Romukeisari/inverter-hardware/mainboard-mini-kicad/mainboard-mini.pdf

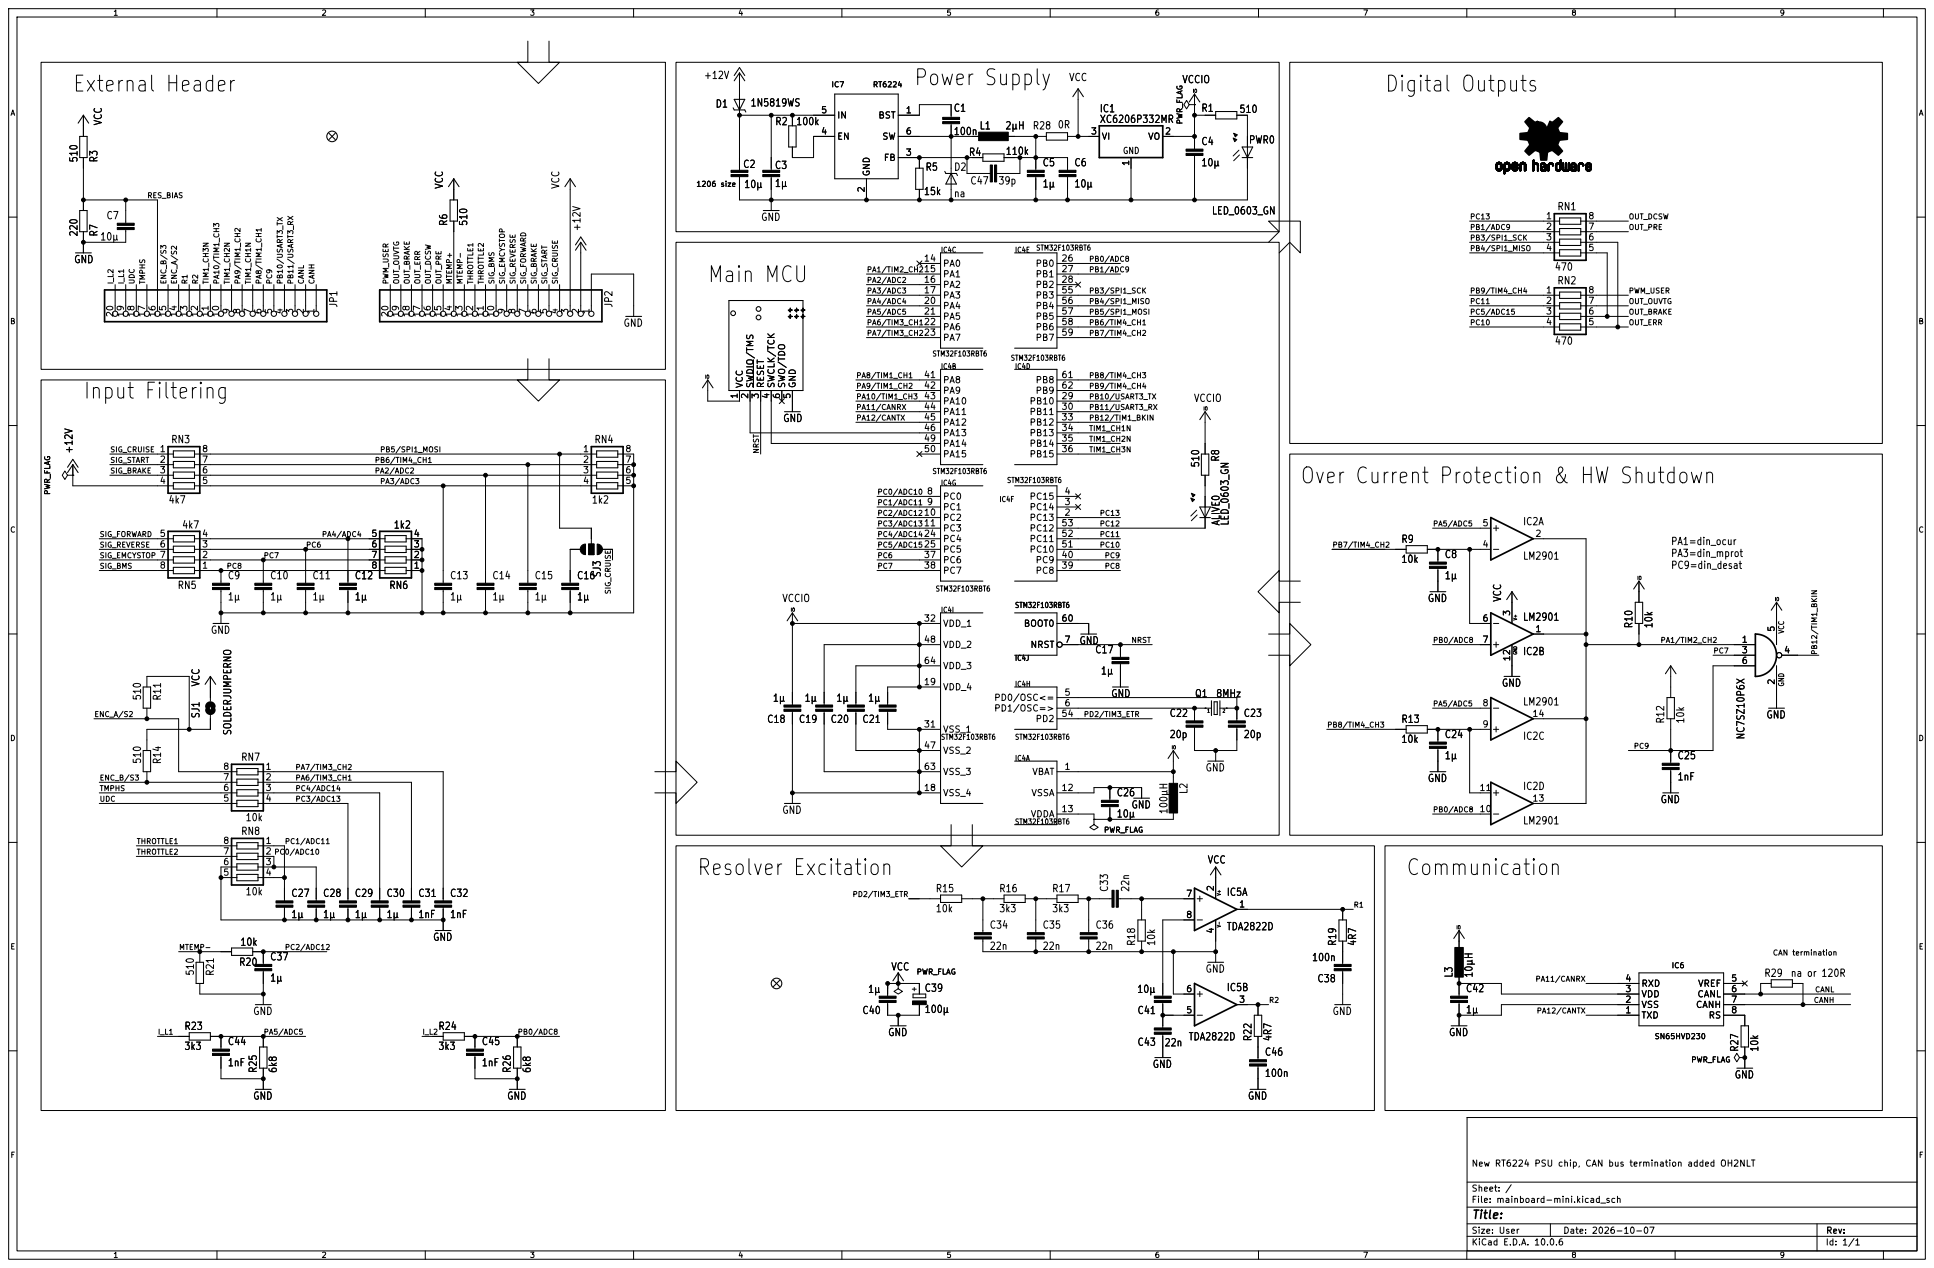
[picture p1: page 1]

F Date: 2026-10-07 KiCad E.D.A. 10.0.6
New RT6224 PSU chip, CAN bus termination added OH2NLT

File: mainboard-mini.kicad_sch Sheet: /
