Romukeisari/inverter-hardware/mainboard-mini-kicad/mainboard-mini.kicad_pcb

## KiCad design mainboard-mini-kicad/mainboard-mini.kicad_pcb (2026-10-22)

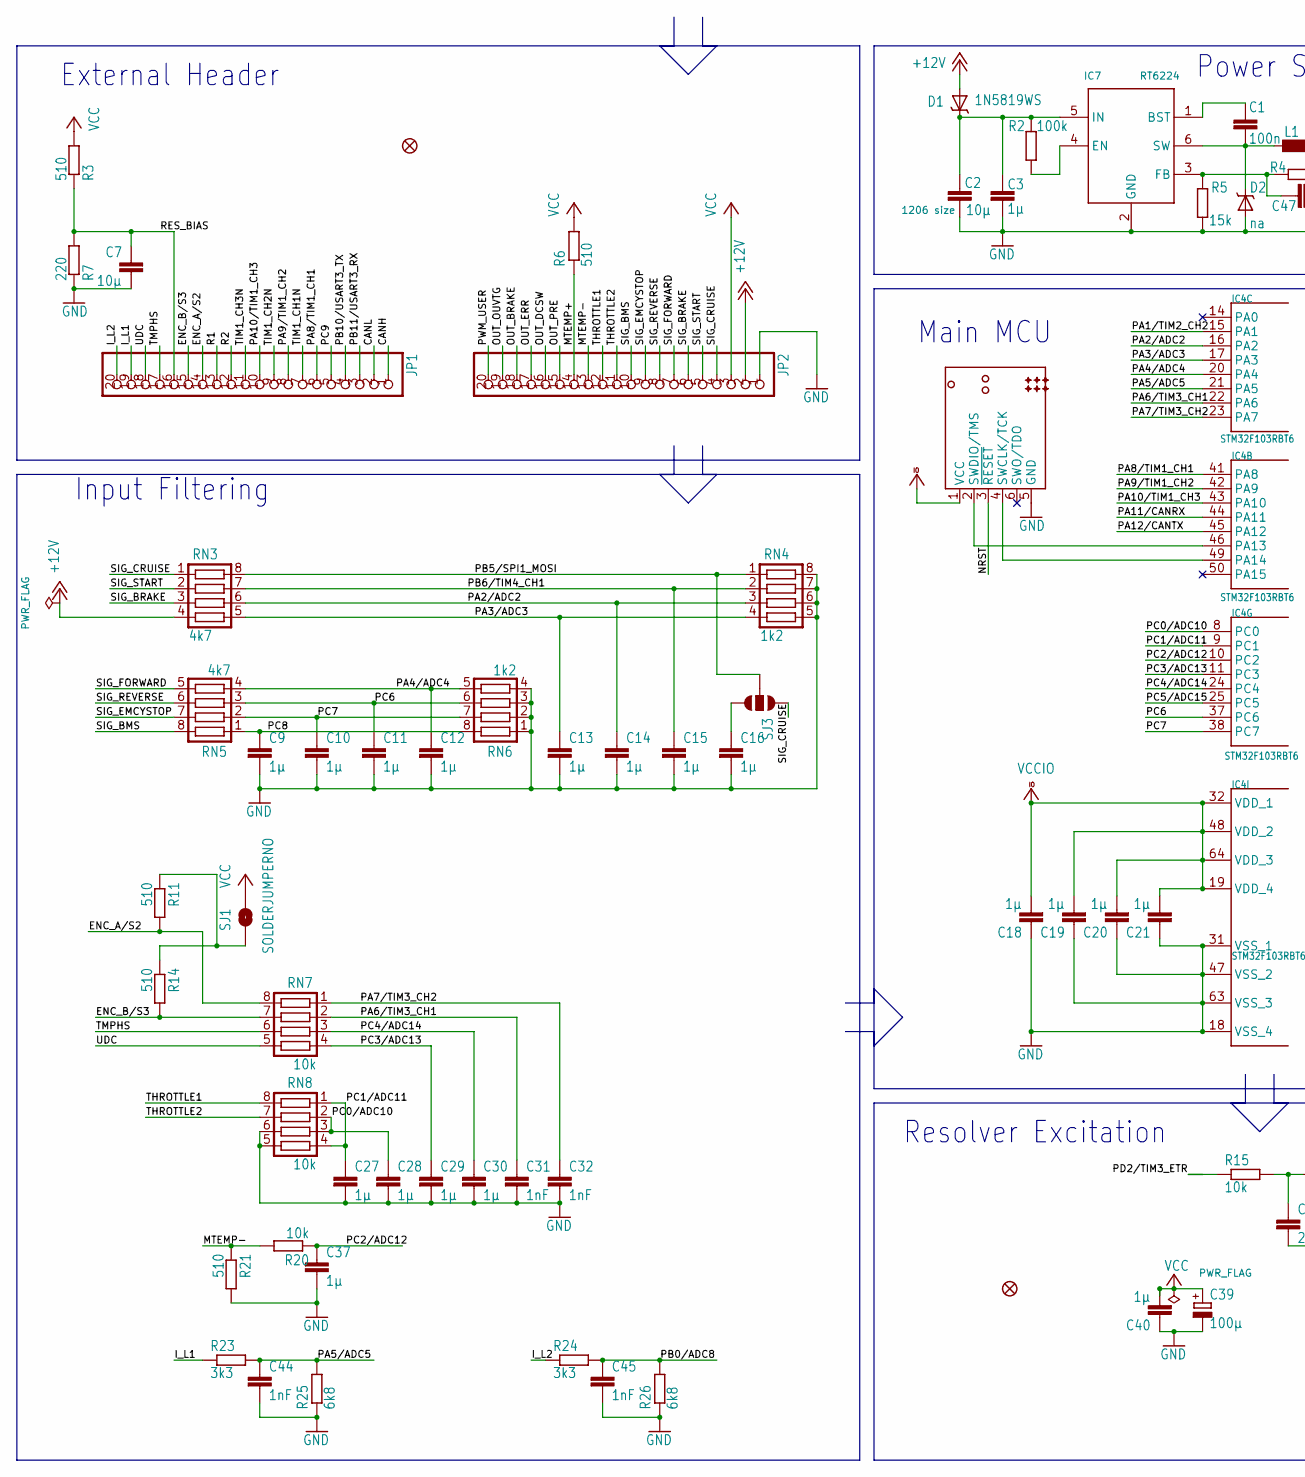
[picture p2: schematic mainboard-mini.kicad_sch, part in row 1, column 1]

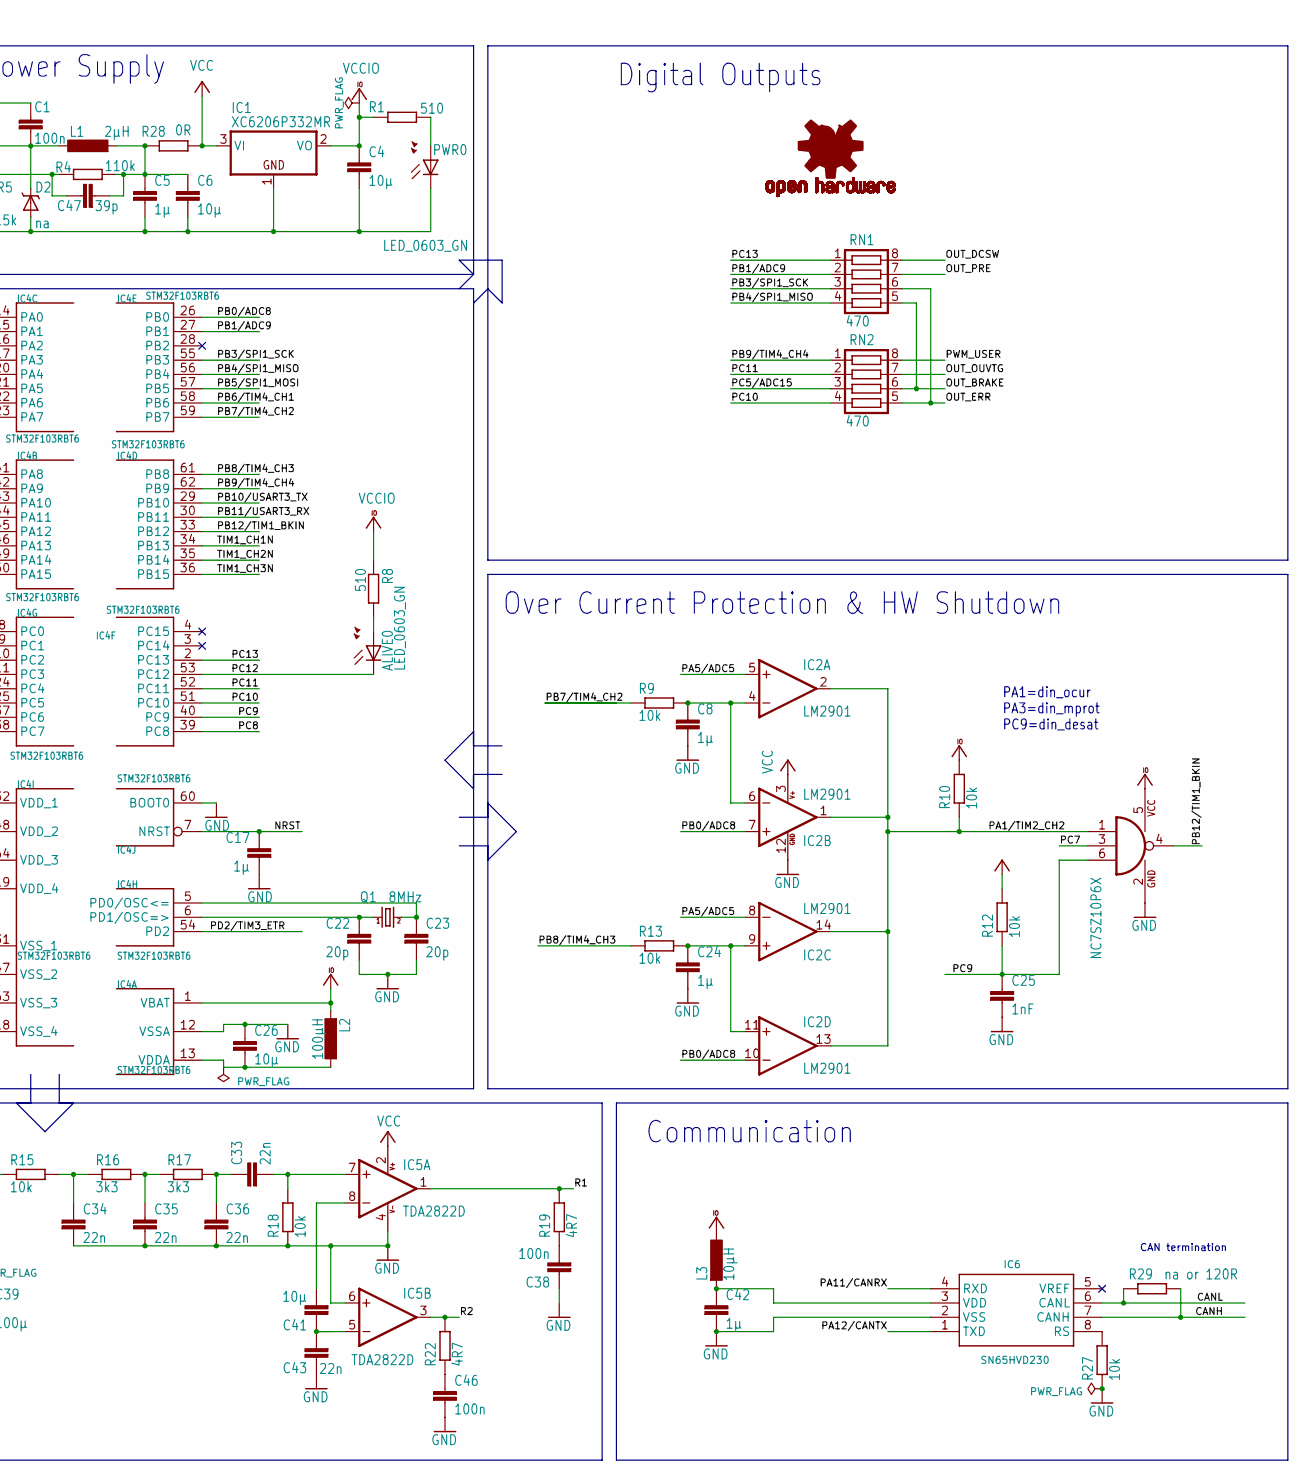
[picture p3: schematic mainboard-mini.kicad_sch, part in row 1, column 2]

Parts:
ALIVE0: LED_0603_GN; SML0805
C1, C38, C46: 100n; C0603
C2: 10µ; C_1206_3216Metric
C3, C5, C8, C9, C10, C11, C12, C13, C14, C15, C16, C17, C18, C19, C20, C21, C24, C27, C28, C29, C30, C37, C40, C42: 1µ; C0603
C4, C6, C7, C26, C41: 10µ; C0603
C22, C23: 20p; C0603
C25, C31, C32, C44, C45: 1nF; C0603
C33, C34, C35, C36, C43: 22n; C0603
C39: 100µ; B_3528-21R
C47: 39p; C_0603_1608Metric
D1: 1N5819WS; SOD-323
D2: na; SOD-323
FID1, FID2: FIDUCIAL1X2.5; FIDUCIAL-1X2.5
IC1: XC6206P332MR; SOT23
IC2: LM2901; SO14
IC3: NC7SZ10P6X; SC70-6
IC4: STM32F103RBT6; TQFP64
IC5: TDA2822D; SO08
IC6: SN65HVD230; SO08
IC7: RT6224; SOT23-6
J1: TC2030_SWD-MCP; TC2030-MCP
JP1, JP2: PINHD-1X20; 1X20
L1: 2µH; L2825P
L2: 100µH; L2012C
L3: 10µH; L2012C
LOGO1: OSHW-LOGOM; OSHW-LOGO-M
PWR0: LED_0603_GN; SML0805
Q1: 8MHz; CRYSTAL-TXC-7A
R1, R3, R6, R8, R11, R14, R21: 510; R0603
R2: 100k; R0603
R4: 110k; R0603
R5: 15k; R0603
R7: 220; R0603
R9, R10, R12, R13, R15, R18, R20, R27: 10k; R0603
R16, R17, R23, R24: 3k3; R0603
R19, R22: 4R7; R0603
R25, R26: 6k8; R0603
R28: 0R; R_0805_2012Metric
R29: na or 120R; R_0603_1608Metric
RN1, RN2: 470; CTS742C083
RN3, RN5: 4k7; CTS742C083
RN4, RN6: 1k2; CTS742C083
RN7, RN8: 10k; CTS742C083
SJ1: SOLDERJUMPERNO; SJ_2S-NO
SJ3: SOLDERJUMPER_2WAYPASTE2&3; SJ_3_PASTE2&3

Connections:
+12V: D1.2 (A), JP2.2, RN3.4
/CANH: IC6.7 (CANH), JP1.1, R29.2
/CANL: IC6.6 (CANL), JP1.2, R29.1
/ENC_A/S2: JP1.14, R11.2, RN7.8
/ENC_B/S3: JP1.15, R14.2, RN7.7
/I_L1: JP1.19, R23.1
/I_L2: JP1.20, R24.1
/MTEMP+: JP2.14, R6.1
/MTEMP-: JP2.13, R20.2, R21.1
/NRST: C17.1, IC4.7 (NRST), J1.3 (~RESET)
/OUT_BRAKE: JP2.18, RN1.5, RN2.6
/OUT_DCSW: JP2.16, RN1.8
/OUT_ERR: JP2.17, RN1.6, RN2.5
/OUT_OUVTG: JP2.19, RN2.7
/OUT_PRE: JP2.15, RN1.7
/PA1/TIM2_CH2: IC2.1 (OUT), IC2.2 (OUT), IC2.13 (OUT), IC2.14 (OUT), IC3.1 (I0), IC4.15 (PA1), R10.1
/PA2/ADC2: C14.1, IC4.16 (PA2), RN3.6, RN4.3
/PA3/ADC3: C13.1, IC4.17 (PA3), RN3.5, RN4.4
/PA4/ADC4: C12.1, IC4.20 (PA4), RN5.4, RN6.5
/PA5/ADC5: C44.1, IC2.5 (+IN), IC2.8 (-IN), IC4.21 (PA5), R23.2, R25.2
/PA6/TIM3_CH1: C31.1, IC4.22 (PA6), RN7.2
/PA7/TIM3_CH2: C32.1, IC4.23 (PA7), RN7.1
/PA8/TIM1_CH1: IC4.41 (PA8), JP1.6
/PA9/TIM1_CH2: IC4.42 (PA9), JP1.8
/PA10/TIM1_CH3: IC4.43 (PA10), JP1.10
/PA11/CANRX: IC4.44 (PA11), IC6.4 (RXD)
/PA12/CANTX: IC4.45 (PA12), IC6.1 (TXD)
/PB0/ADC8: C45.1, IC2.7 (+IN), IC2.10 (-IN), IC4.26 (PB0), R24.2, R26.2
/PB1/ADC9: IC4.27 (PB1), RN1.2
/PB3/SPI1_SCK: IC4.55 (PB3), RN1.3
/PB4/SPI1_MISO: IC4.56 (PB4), RN1.4
/PB5/SPI1_MOSI: IC4.57 (PB5), RN3.8, RN4.1, SJ3.2
/PB6/TIM4_CH1: C15.1, IC4.58 (PB6), RN3.7, RN4.2
/PB7/TIM4_CH2: IC4.59 (PB7), R9.1
/PB8/TIM4_CH3: IC4.61 (PB8), R13.1
/PB9/TIM4_CH4: IC4.62 (PB9), RN2.1
/PB10/USART3_TX: IC4.29 (PB10), JP1.4
/PB11/USART3_RX: IC4.30 (PB11), JP1.3
/PB12/TIM1_BKIN: IC3.4 (O), IC4.33 (PB12)
/PC0/ADC10: C28.1, IC4.8 (PC0), RN8.2, RN8.3
/PC1/ADC11: C27.1, IC4.9 (PC1), RN8.1, RN8.4
/PC2/ADC12: C37.1, IC4.10 (PC2), R20.1
/PC3/ADC13: C29.1, IC4.11 (PC3), RN7.4
/PC4/ADC14: C30.1, IC4.24 (PC4), RN7.3
/PC5/ADC15: IC4.25 (PC5), RN2.3
/PC6: C11.1, IC4.37 (PC6), RN5.3, RN6.6
/PC7: C10.1, IC3.3 (I1), IC4.38 (PC7), RN5.2, RN6.7
/PC8: C9.1, IC4.39 (PC8), RN5.1, RN6.8
/PC9: C25.1, IC3.6 (I2), IC4.40 (PC9), JP1.5, R12.1
/PC10: IC4.51 (PC10), RN2.4
/PC11: IC4.52 (PC11), RN2.2
/PC12: ALIVE0.C, IC4.53 (PC12)
/PC13: IC4.2 (PC13), RN1.1
/PD2/TIM3_ETR: IC4.54 (PD2), R15.1
/PWM_USER: JP2.20, RN2.8
/R1: IC5.1 (OUT), JP1.13, R19.2
/R2: IC5.3 (OUT), JP1.12, R22.2
/RES_BIAS: C7.1, JP1.16, R3.1, R7.2
/SIG_BMS: JP2.10, RN5.8
/SIG_BRAKE: JP2.6, RN3.3
/SIG_CRUISE: JP2.4, RN3.1, SJ3.1
/SIG_EMCYSTOP: JP2.9, RN5.7
/SIG_FORWARD: JP2.7, RN5.5
/SIG_REVERSE: JP2.8, RN5.6
/SIG_START: JP2.5, RN3.2
/THROTTLE1: JP2.12, RN8.8
/THROTTLE2: JP2.11, RN8.7
/TIM1_CH1N: IC4.34 (PB13), JP1.7
/TIM1_CH2N: IC4.35 (PB14), JP1.9
/TIM1_CH3N: IC4.36 (PB15), JP1.11
/TMPHS: JP1.17, RN7.6
/UDC: JP1.18, RN7.5
GND: C2.2, C3.2, C4.2, C5.2, C6.2, C7.2, C8.2, C9.2, C10.2, C11.2, C12.2, C13.2, C14.2, C15.2, C16.2, C17.2, C18.1, C19.1, C20.1, C21.1, C22.2, C23.2, C24.2, C25.2, C26.1, C27.2, C28.2, C29.2, C30.2, C31.2, C32.2, C34.2, C35.2, C36.2, C37.2, C38.1, C39.-, C40.1, C42.2, C43.1, C44.2, C45.2, C46.2, D2.2 (A), IC1.1 (GND), IC2.12 (GND), IC3.2 (GND), IC4.12 (VSSA), IC4.18 (VSS_4), IC4.31 (VSS_1), IC4.47 (VSS_2), IC4.60 (BOOT0), IC4.63 (VSS_3), IC5.4 (V-), IC5.6 (+IN), IC6.2 (VSS), IC7.2 (GND), J1.5 (GND), JP2.1, PWR0.C, R5.1, R7.1, R18.1, R21.2, R25.1, R26.1, R27.1, RN4.5, RN4.6, RN4.7, RN4.8, RN6.1, RN6.2, RN6.3, RN6.4, RN8.5, RN8.6
unnamed: ALIVE0.A, R8.2
unnamed: C16.1, SJ3.3
unnamed: C33.1, C36.1, R17.2
unnamed: C34.1, R15.2, R16.1
unnamed: C35.1, R16.2, R17.1
unnamed: C38.2, R19.1
unnamed: C46.1, R22.1
unnamed: C5.1, C6.1, C47.2, L1.2, R4.1, R28.2
unnamed: C2.1, C3.1, D1.1 (C), IC7.5 (IN), R2.2
unnamed: C1.2, D2.1 (C), IC7.6 (SW), L1.1
unnamed: C8.1, IC2.4 (-IN), IC2.6 (-IN), R9.2
unnamed: C24.1, IC2.9 (+IN), IC2.11 (+IN), R13.2
unnamed: C26.2, IC4.13 (VDDA), L2.1
unnamed: IC4.46 (PA13), J1.2 (SWDIO/TMS)
unnamed: IC4.49 (PA14), J1.4 (SWCLK/TCK)
unnamed: C23.1, IC4.5 (PD0/OSC<=), Q1.P$2 (2)
unnamed: C22.1, IC4.6 (PD1/OSC=>), Q1.P$1 (1)
unnamed: C33.2, IC5.7 (+IN), R18.2
unnamed: C41.2, IC5.8 (-IN)
unnamed: C41.1, C43.2, IC5.5 (-IN)
unnamed: IC6.8 (RS), R27.2
unnamed: C42.1, IC6.3 (VDD), L3.2
unnamed: C1.1, IC7.1 (BST)
unnamed: IC7.4 (EN), R2.1
unnamed: C47.1, IC7.3 (FB), R4.2, R5.2
unnamed: PWR0.A, R1.2
unnamed: R11.1, R14.1, SJ1.1
VCC: C39.+, C40.2, IC1.3 (VI), IC2.3 (V+), IC5.2 (V+), JP2.3, R3.2, R6.2, R12.2, R28.1, SJ1.2
VCCIO: C4.1, C18.2, C19.2, C20.2, C21.2, IC1.2 (VO), IC3.5 (VCC), IC4.1 (VBAT), IC4.19 (VDD_4), IC4.32 (VDD_1), IC4.48 (VDD_2), IC4.64 (VDD_3), J1.1 (VCC), L2.2, L3.1, R1.1, R8.1, R10.2

Notes on the sheet:
Power Supply
CAN termination
Digital Outputs
PA1=din_ocur PA3=din_mprot PC9=din_desat
Main MCU
External Header
Over Current Protection & HW Shutdown
Communication
Input Filtering
Resolver Excitation

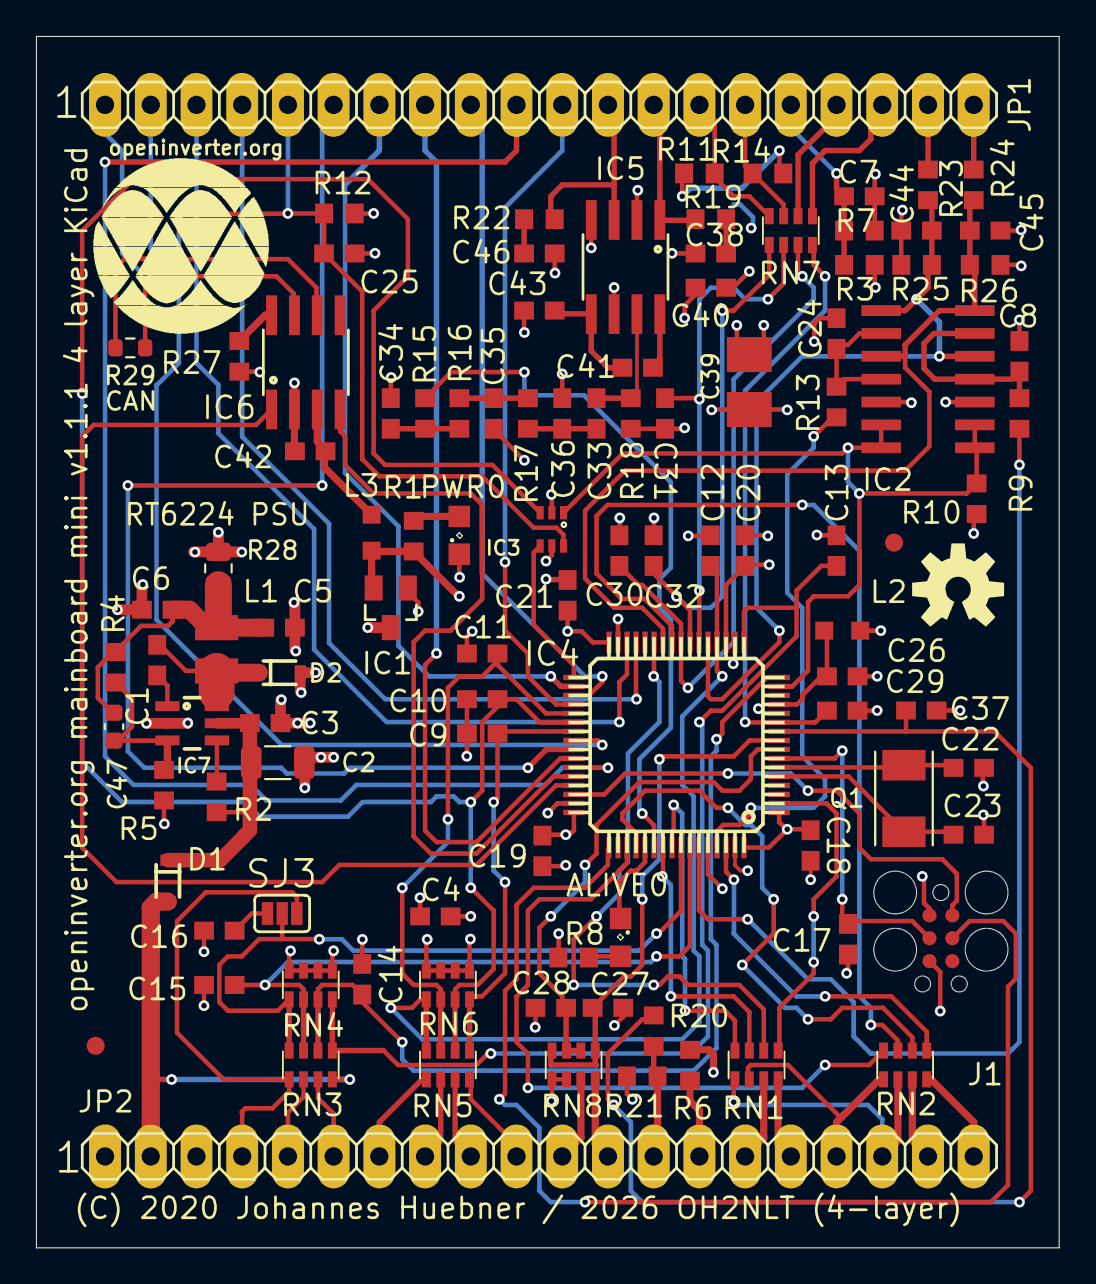
[picture p4: board mainboard-mini.kicad_pcb from above]

Board: 4 copper layers, 56.8 x 67.3 mm, 108 parts (1 on the bottom side), 102 nets.

Other parts of the board:
U$2: OI_LOGO
