Romukeisari/inverter-hardware/(notices)

Notices in the files:
mainboard-mini-kicad/mainboard-mini.kicad_pcb:
(C) 2020 Johannes Huebner / 2026 OH2NLT (4-layer)
parts and their libraries:
PADDescription 1MCLR/Vpp 2Vdd 3GND 4PGD (ISPDAT) 5PGC (ISPCLK) 6nc (used for LVP) ©2009 ROFA.cz - modified and updated by Robert Darlington ‹rdarlington@gmail.com›
